liujycode/liberai_liu/BNO080_HAND_DIY/ci_test_20260427_174046.txt

==============================================================================
  BNO_HAND CI 测试报告  —  2026-04-27 17:40:46
==============================================================================
  请求CI     请求ms    实际CI     实际ms   rx_fps   fw_fps   drop%      帧数  备注
------------------------------------------------------------------------------
     6      7.5       6      7.5     97.9    160.2   40.0%    1465  Windows 接受
 range    range       6      7.5     97.7    158.7   39.5%    1463  默认范围 6-24
==============================================================================

  最优 CI = 6 (7.5ms)  rx=97.9fps  drop=40.0%

==============================================================================
  3 轮聚合报告  —  2026-04-27 17:40:46
==============================================================================
  请求CI     请求ms    实际CI      rx_fps μ±σ      fw_fps μ±σ     drop% μ±σ  备注
------------------------------------------------------------------------------
     6      7.5       6    97.9±1.0     160.1±0.6     40.0±0.6    Windows 接受
 range    range       6    96.9±0.8     159.5±0.6     39.9±0.4    默认范围 6-24
==============================================================================

  最优 CI = 6 (7.5ms)  rx=99.1fps  drop=39.2%
