liujycode/liberai_liu/BNO080_HAND_DIY/ci_test_20260427_175127.txt

==============================================================================
  BNO_HAND CI 测试报告  —  2026-04-27 17:51:27
==============================================================================
  请求CI     请求ms    实际CI     实际ms   rx_fps   fw_fps   drop%      帧数  备注
------------------------------------------------------------------------------
     6      7.5       6      7.5     98.1    158.7   38.9%    1526  Windows 接受
     8     10.0       8     10.0     82.7    164.8   50.0%    1229  Windows 接受
    10     12.5      10     12.5     75.8    163.4   54.1%    1164  Windows 接受
    12     15.0      12     15.0     55.6    164.3   66.5%     824  Windows 接受
    16     20.0      16     20.0     42.0    165.3   74.5%     650  Windows 接受
    20     25.0      20     25.0     35.0    166.9   78.9%     531  Windows 接受
    24     30.0      24     30.0     31.5    166.1   81.1%     471  Windows 接受
    40     50.0      40     50.0     19.0    166.2   88.6%     292  Windows 接受
 range    range       6      7.5     96.7    160.3   40.6%    1451  默认范围 6-24
==============================================================================

  最优 CI = 6 (7.5ms)  rx=98.1fps  drop=38.9%

==============================================================================
  3 轮聚合报告  —  2026-04-27 17:51:27
==============================================================================
  请求CI     请求ms    实际CI      rx_fps μ±σ      fw_fps μ±σ     drop% μ±σ  备注
------------------------------------------------------------------------------
     6      7.5       6    97.8±0.7     159.2±0.4     39.3±0.3    Windows 接受
     8     10.0       8    82.1±0.8     163.6±1.0     50.0±0.0    Windows 接受
    10     12.5      10    75.5±0.5     163.4±0.0     54.1±0.1    Windows 接受
    12     15.0      12    54.8±0.7     164.0±0.7     66.5±0.1    Windows 接受
    16     20.0      16    42.5±0.4     165.8±0.5     74.6±0.0    Windows 接受
    20     25.0      20    35.1±0.1     166.6±0.6     78.9±0.1    Windows 接受
    24     30.0      24    31.4±0.2     165.1±1.2     80.9±0.1    Windows 接受
    40     50.0      40    18.8±0.2     166.7±0.4     88.6±0.0    Windows 接受
 range    range       6    96.9±1.1     160.6±0.2     40.6±0.2    默认范围 6-24
==============================================================================

  最优 CI = 6 (7.5ms)  rx=98.1fps  drop=38.9%
