liujycode/liberai_liu/BNO080_HAND_DIY/ci_test_20260427_174046.csv

run | ci_idx | requested_ci | req_ms | firmware_ci | actual_ms | rx_fps | fw_fps | drop_pct | drop_total | frame_total | xor_err | note
1 | 1 | 6 | 7.50 | 6 | 7.50 | 99.07 | 159.30 | 39.21 | 957 | 1484 | 0 | Windows 接受
1 | 2 | 0 | range | 6 | 7.50 | 95.84 | 160.14 | 40.55 | 1019 | 1494 | 0 | 默认范围 6-24
2 | 1 | 6 | 7.50 | 6 | 7.50 | 96.63 | 160.78 | 40.64 | 994 | 1452 | 0 | Windows 接受
2 | 2 | 0 | range | 6 | 7.50 | 97.09 | 159.59 | 39.72 | 997 | 1513 | 0 | 默认范围 6-24
3 | 1 | 6 | 7.50 | 6 | 7.50 | 97.90 | 160.23 | 40.01 | 977 | 1465 | 0 | Windows 接受
3 | 2 | 0 | range | 6 | 7.50 | 97.70 | 158.72 | 39.52 | 956 | 1463 | 0 | 默认范围 6-24
