liujycode/liberai_liu/BNO080_HAND_DIY/ci_test_20260427_175127_agg.csv

requested_ci | req_ms | firmware_ci | rx_fps_mean | rx_fps_std | fw_fps_mean | fw_fps_std | drop_pct_mean | drop_pct_std | drop_total_sum | note
6 | 7.50 | 6 | 97.81 | 0.67 | 159.15 | 0.37 | 39.33 | 0.35 | 2922 | Windows 接受
8 | 10.00 | 8 | 82.12 | 0.83 | 163.64 | 1.01 | 49.98 | 0.00 | 3665 | Windows 接受
10 | 12.50 | 10 | 75.51 | 0.52 | 163.41 | 0.04 | 54.08 | 0.13 | 4032 | Windows 接受
12 | 15.00 | 12 | 54.85 | 0.74 | 163.95 | 0.73 | 66.47 | 0.06 | 4945 | Windows 接受
16 | 20.00 | 16 | 42.47 | 0.36 | 165.83 | 0.51 | 74.56 | 0.03 | 5631 | Windows 接受
20 | 25.00 | 20 | 35.06 | 0.11 | 166.63 | 0.60 | 78.88 | 0.14 | 5942 | Windows 接受
24 | 30.00 | 24 | 31.39 | 0.19 | 165.07 | 1.16 | 80.94 | 0.13 | 6019 | Windows 接受
40 | 50.00 | 40 | 18.84 | 0.19 | 166.71 | 0.36 | 88.65 | 0.04 | 6691 | Windows 接受
0 | range | 6 | 96.92 | 1.09 | 160.62 | 0.20 | 40.60 | 0.19 | 3009 | 默认范围 6-24
