liujycode/liberai_liu/BNO080_HAND_DIY/My_Project.pdf

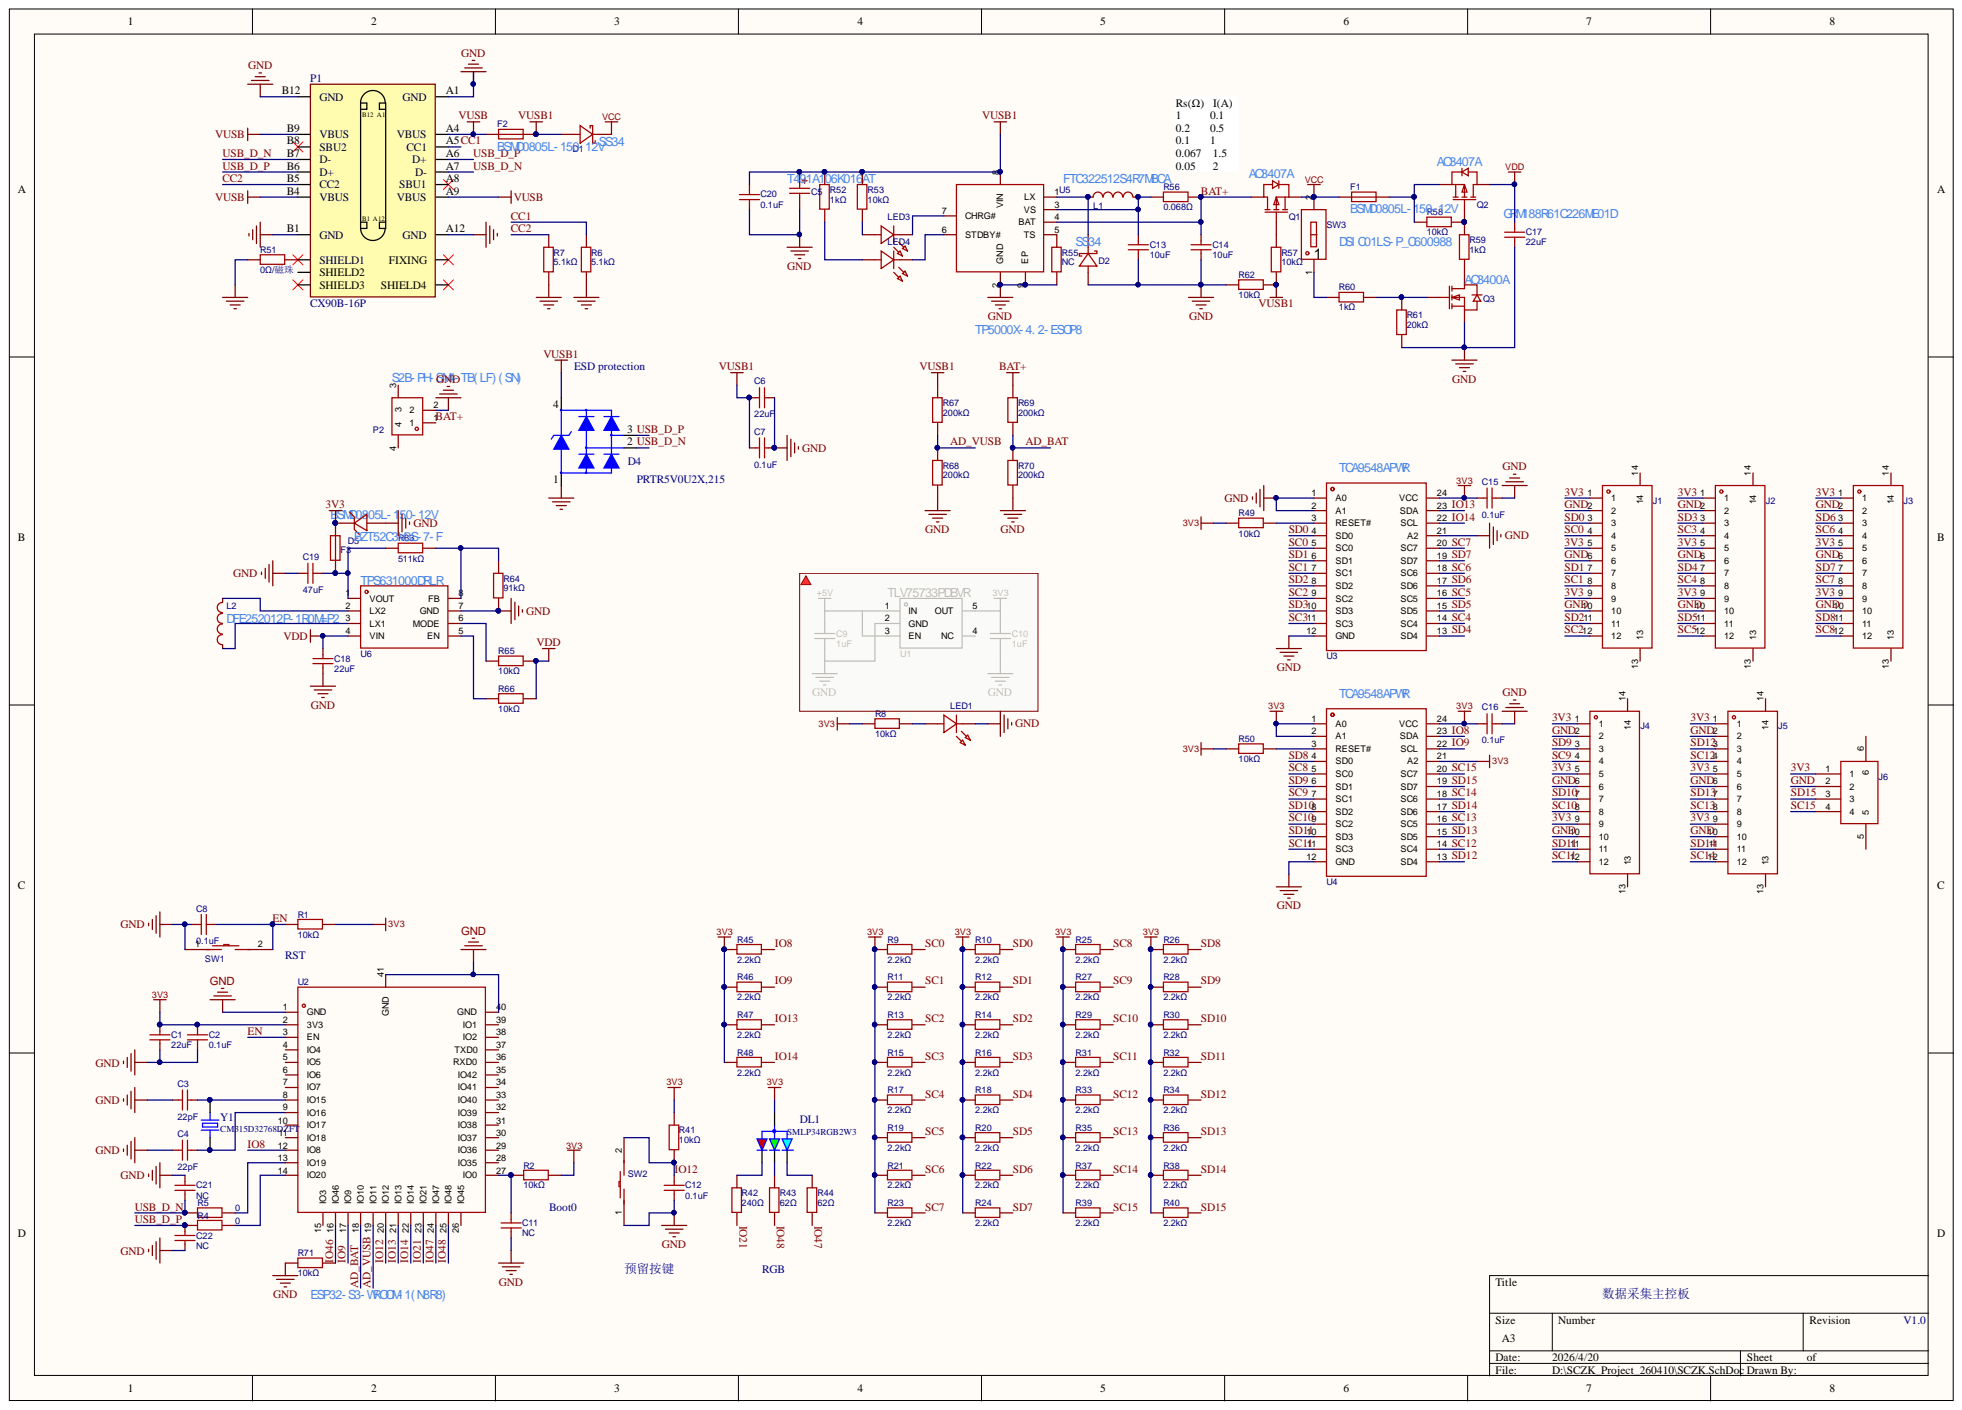
[picture p3: page 1]

S2B- PH- SGMN4D- TB( LF) ( SN)

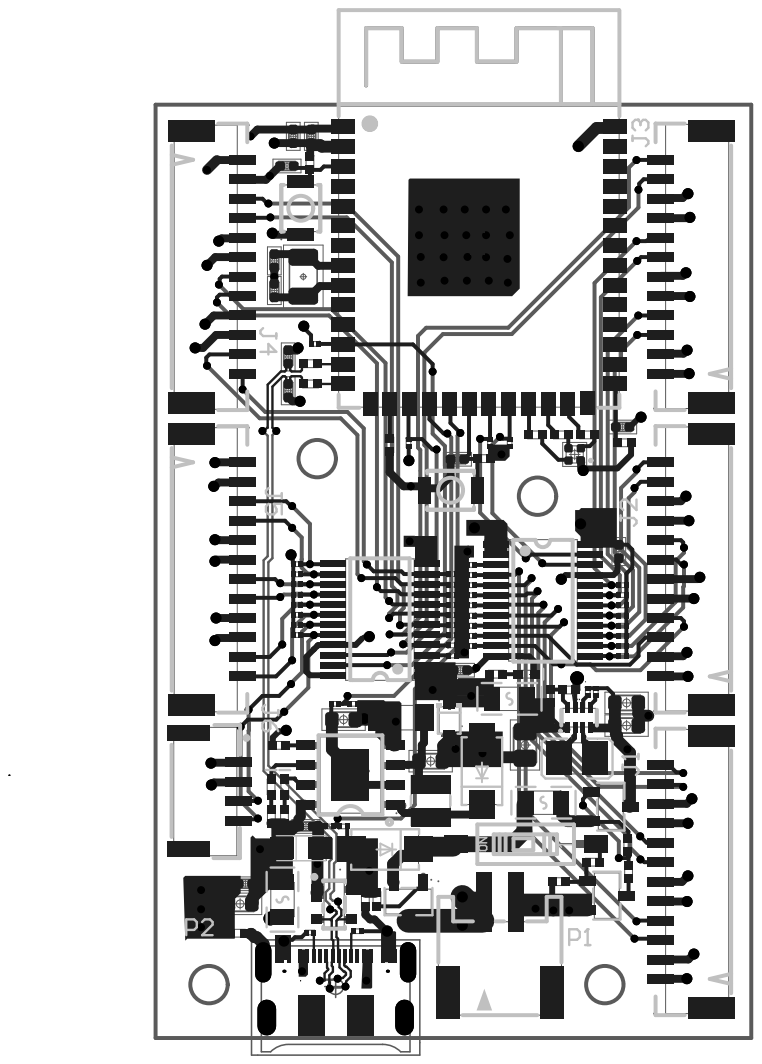
[picture p4: page 2]

# Board Stack Report
