liujycode/liberai_liu/(commit log)

2026-04-24 BNO080_HAND_DIY v2.20: 修复 GH OTA URL + OTA 彩虹 LED
    [BNO080_HAND_DIY.ino]
2026-04-24 BNO080_HAND_DIY v2.21: OTA 测试版本 v2.21
2026-04-24 BNO080_HAND_DIY v2.21: 紫色LED提示OTA检查阶段
2026-04-24 BNO080_HAND_DIY v2.22: 紫色LED提示OTA检查阶段
2026-04-24 BNO080_HAND_DIY v2.23: LED优先级修复：无传感器红灯高于BLE蓝灯
2026-04-28 BNO080_HAND_DIY v2.42: 还原默认 BLE 输出 91B 全帧（s_ble_compact=false），修复 v2.41 上位机不兼容问题
    [ci_test_20260427_174046.csv, ci_test_20260427_174046_agg.csv, ci_test_20260427_175127.csv, ci_test_20260427_175127_agg.csv]
